bgomberg/roboshield/README.md

This is the public repository for the Cal Poly RoboShield. See http://roboshield.github.io/roboshield/index for more information.

# Authors
Brian Gomberg, John Seng

# Installation

Below are instructions for installing this library with Arduino 1.6.x:

1. Download this repository as a .zip by clicking on the "Download ZIP" button on GitHub.
2. In Arduino, create a new project and go to "Sketch" -> "Include Library" -> "Add .ZIP Library..." and select the .zip you just downloaded.
4. Arduino will automatically import the library and place the proper #include at the top.
5. In the future, you can skip step 1 and simply select the library within the "Sketch" -> "Include Library" list for step 2.
