bgomberg/roboshield/(threads)

Thread 3 (2015-08-23):

Add solder bridge for non-r3 boards

bgomberg, 2015-08-23:
We should add a solder bridge for working with Arduinos without an IOREF pin. The solder bridge would connect IOREF to either 3.3V or 5V.

bgomberg, 2015-09-28:
No longer applicable.

Closed 2015-09-28.

Thread 6 (2015-08-23):

Power switch not super easy to use

bgomberg, 2015-08-23:
The power switch is a bit hard to use because of proximity with motor screw terminals. I'm not sure what can be done about this.

Closed 2015-09-28.

Thread 7 (2015-08-23):

Don't use RX/TX pins for LED/Button

bgomberg, 2015-08-23:
We should see if we could avoid using these pins all-together. We should at least not use them for the button / LED as this will mess with people who want to use the serial monitor.

jsseng, 2015-08-24:
Isn't the serial monitor a 1-way output?  Can we a leave the LED on the TX and the RX will be prevent serial input?

jsseng, 2015-08-24:
The button could also go on the battery analog input.

bgomberg, 2015-08-24:
Somebody might want to type stuff into the serial monitor for debugging purposes.

bgomberg, 2015-08-31:
Move the BTN to the LCD_RS pin.

Closed 2015-09-28.

Thread 10 (2015-10-30):

RT6238A is shutting down when high current draw

jsseng, 2015-10-30:
Regulator shuts off when using a digital servo.

The RT6238A has a latched undervoltage protection mode.  When the output voltage goes below 60% of the desired voltage (for more than 270uS), the regulator shuts off and requires toggling the enable.

I was looking at the RT7258, and it restarts the regulator every 2ms after an undervoltage condition.

Closed 2015-11-15.

Thread 14 (2015-10-30):

move the the i2c header down slightly

jsseng, 2015-10-30:
When the IMU is soldered on, it clears the LCD header, but it is very close.  Moving the i2c header down could give a little more clearance.

Closed 2015-11-15.

Thread 15 (2015-10-30):

provide option for battery monitoring with 3.3V board

jsseng, 2015-10-30:
As far as I can tell, the board is compatible with the Due except for the battery monitoring.  If the board is powered with 12V, then the analog input will get 4V which is too high for the Due.

There could be a solder bridge or unpopulated resistor footprint for someone to solder in a new resistor if the board is used with a Due.

Closed 2015-11-15.

Thread 16 (2016-01-02):

Power connector interferes with MOSFET

jsseng, 2016-01-02:
I'm using the bigger power connector (compared with the motors).  They seems to interfere.

Closed 2016-01-04.

Thread 18 (2016-01-02):

Move the 18K resistor for switching regulator

jsseng, 2016-01-02:
If the 18K resistor for the switching regulator could be moved (just slightly) into a more open area, someone could easily modify the output voltage.  They could solder another resistor on top to change the voltage divider.

Closed 2016-01-04.
