bgomberg/roboshield/(commit log)

2015-08-23 Got LCD, button, LED, servo pins working
2015-08-23 Added print class support
2015-08-24 added motorInit function (not tested)
2015-08-24 Started implementing servos.
2015-08-25 fixed motor timer and added debugging mode
    [RoboShield.cpp, bringup.ino]
2015-08-25 improved motor functions
2015-08-26 added encoder functions
2015-08-26 added function to print floats
2015-08-28 show encoder counts
2015-08-29 print long unsigned for encoder
2015-08-29 Got all servos working.
2015-08-31 removed servo ISR digitalWrite
2015-10-28 updated pin mappings
2015-10-28 commented out old pinout for motors
2015-10-28 working LCD code for v0.2 board
2015-10-28 working motor code
2015-10-28 changed encoder code for v0.2
2015-10-29 code for MPU6050 accelerometer/gyroscope
2015-10-29 move IMU test to debug mode
2016-01-05 fixed analog input test
    [RoboShield.cpp]
2016-01-22 added accelerometer and gyro functions
2016-02-15 Made into proper Arduino library and cleaned up a bit
